TomaszDzieduszynski/haptolin/images/photo1.jpg

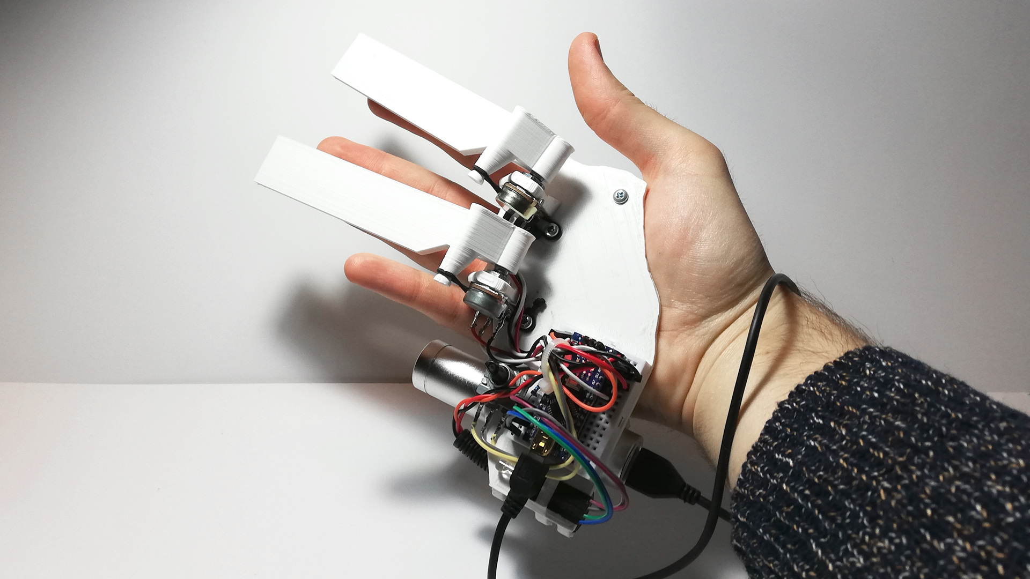
images/photo1.jpg
