TomaszDzieduszynski/haptolin/images/photo2.jpg

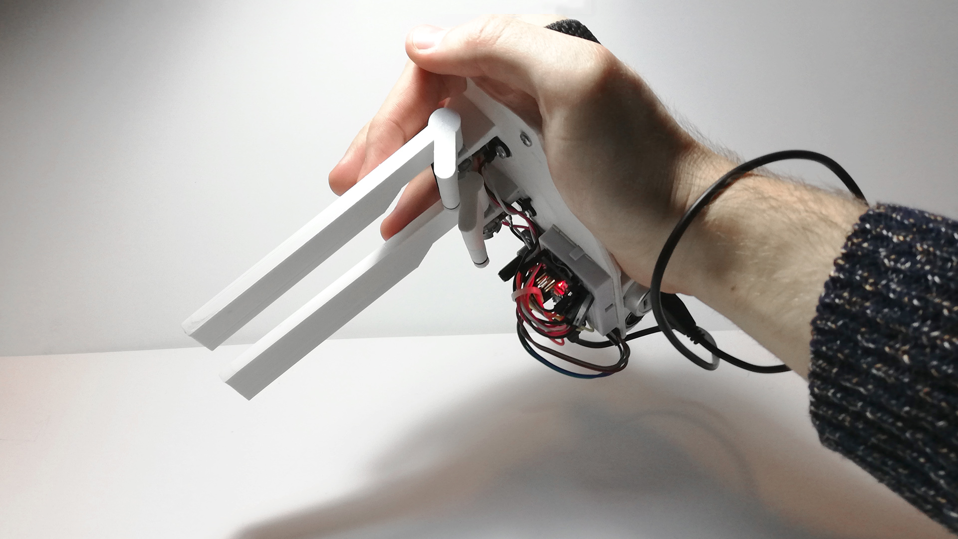
images/photo2.jpg
