TomaszDzieduszynski/haptolin/images/photo3.jpg

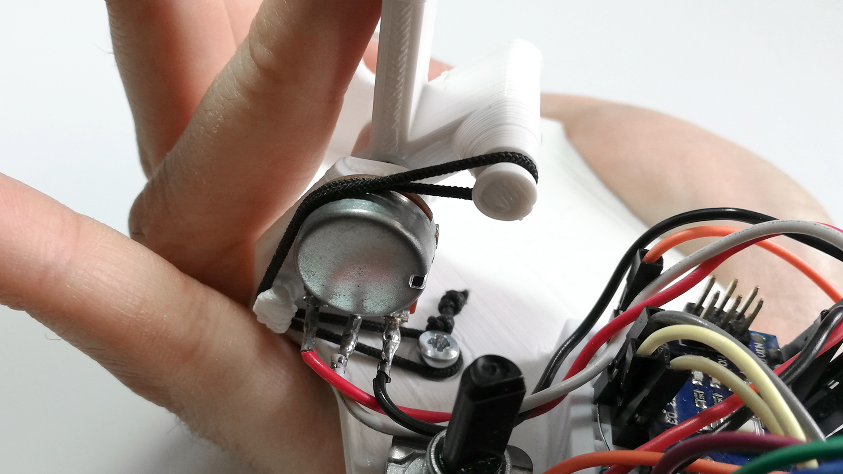
images/photo3.jpg
