TomaszDzieduszynski/haptolin/images/photo4.jpg

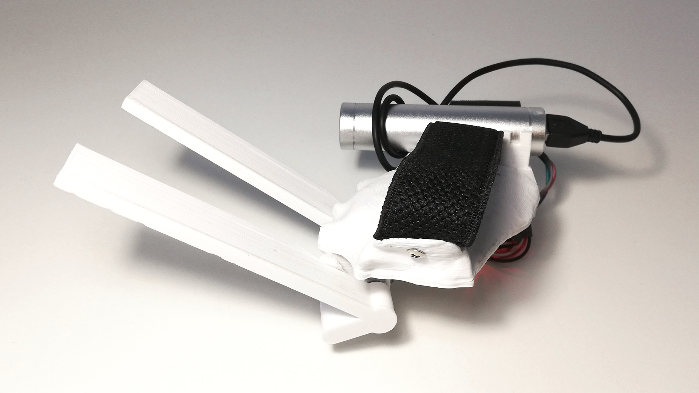
images/photo4.jpg
