TomaszDzieduszynski/haptolin/images/photo5.jpg

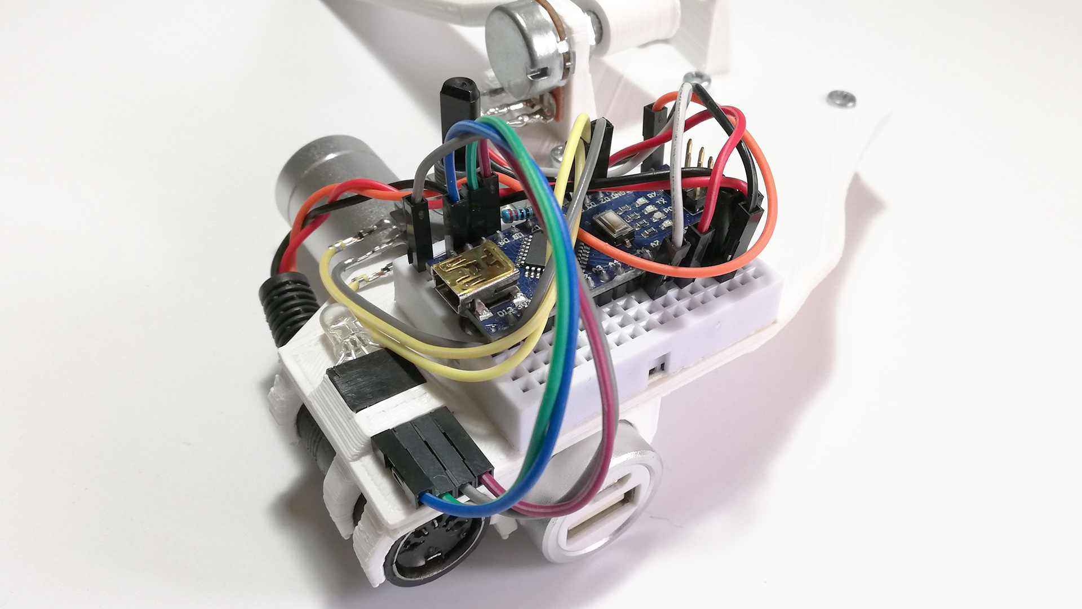
images/photo5.jpg
