TomaszDzieduszynski/haptolin/images/photo6.jpg

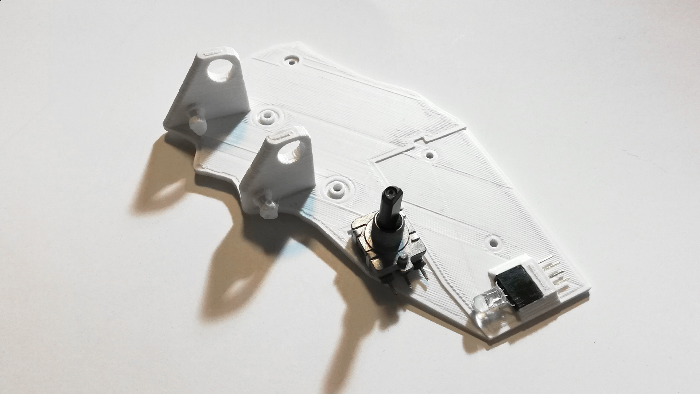
images/photo6.jpg
