TomaszDzieduszynski/haptolin/images/photo7.jpg

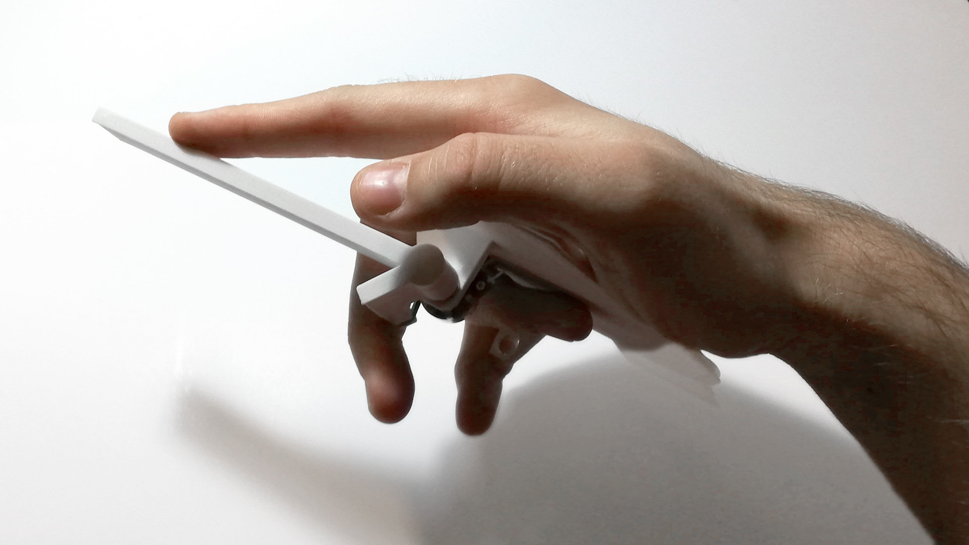
images/photo7.jpg
