TomaszDzieduszynski/haptolin/images/photo8.jpg

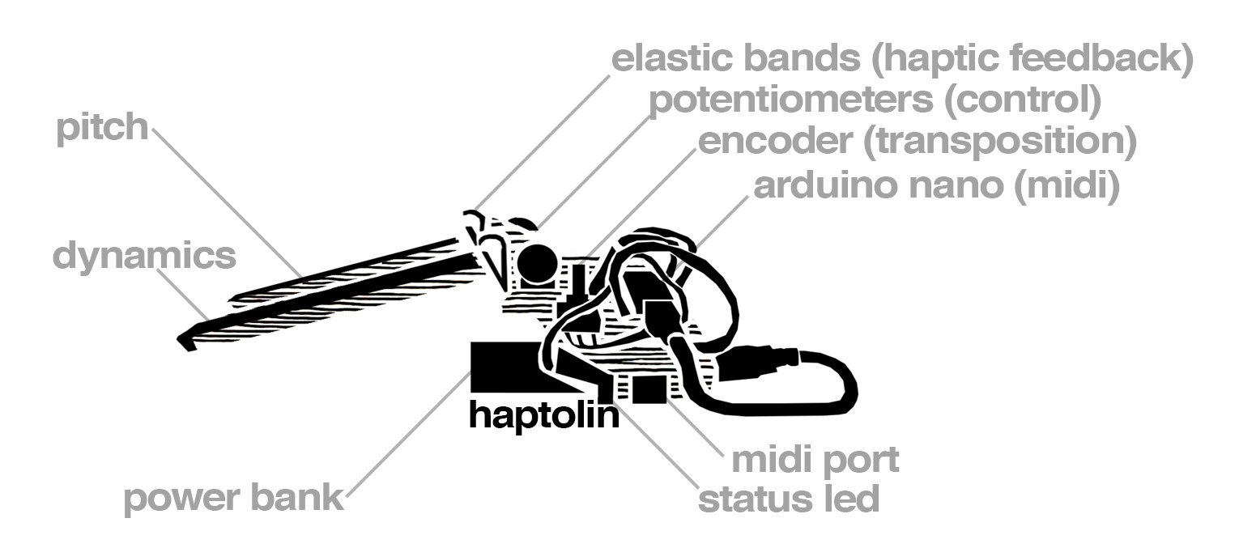
images/photo8.jpg
