TomaszDzieduszynski/haptolin/stl/haptolin_v4_upperhalf.stl

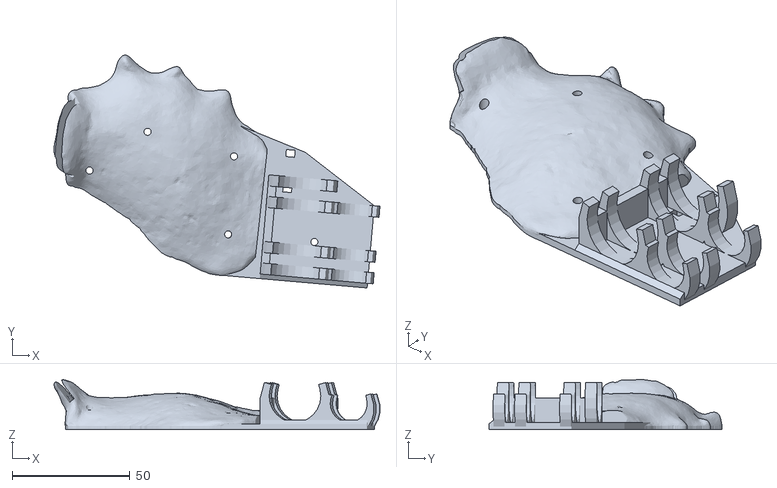
[picture p11: CAD file, 2026-10-31]
stl/haptolin_v4_upperhalf.stl
138.2 x 98.8 x 21.3
