TomaszDzieduszynski/haptolin/stl/haptolin_v4_keys.stl

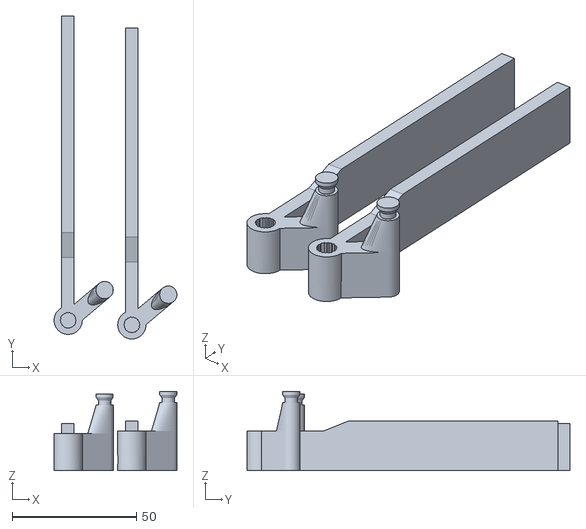
[picture p12: CAD file, 2026-10-31]
stl/haptolin_v4_keys.stl
49.5 x 130.1 x 31.9
