TomaszDzieduszynski/haptolin/stl/haptolin_v4_lowerhalf.stl

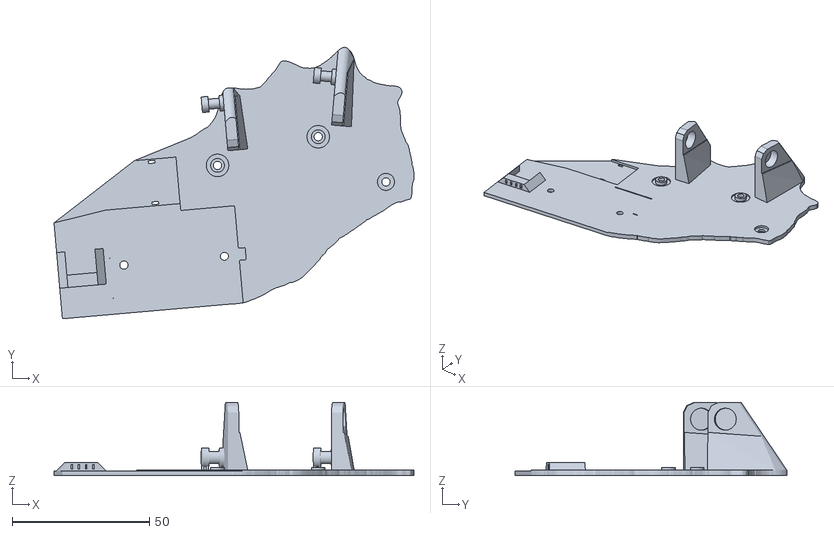
[picture p13: CAD file, 2026-10-31]
stl/haptolin_v4_lowerhalf.stl
131.0 x 98.8 x 26.6
